pereiraafl/rodeiro/DIAGRAM.md

# Esquemático elétrico

### Diagrama do Arduino responsável por obter a temperatura

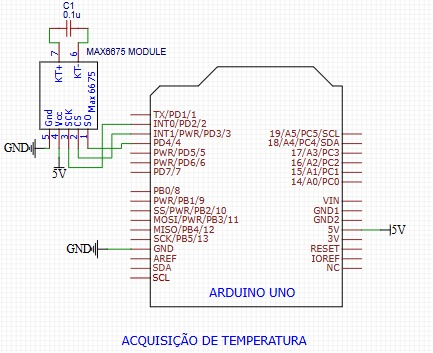
[picture p3: assets/arduino_temp.jpeg]
ArduinoTemp


### Diagrama do Arduino responsável pelo controle do inversor e da central hidráulica

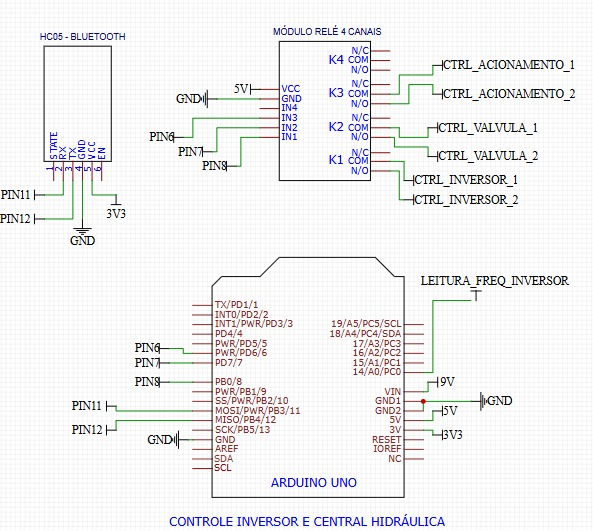
[picture p4: assets/arduino_control.jpeg]
ArduinoControl
