pereiraafl/rodeiro/(commit log)

2024-09-28 Update - Comments and timings
    - Added comments to the code
    - Reset the timings between braking proceedures
    - Commented the valve-closing section to allow the fluid to keep moving during acceleration
2024-10-09 Update: thermocouple and LCD
    > Added thermocouple readings and LCD prints to code
    > Added comments to describe the new parts of the code
2024-10-14 Add arduino nano code
2024-10-14 Update arduino uno code
2024-10-14 Add python script to interact with arduinos
2024-10-14 Remove rodeiro.ino since its code is now on arduino_uno.ino
2024-10-31 Add socket echo implementation
2024-10-31 Add on/off socket logic
2024-10-31 Add socket and test integration with on/off logic
2024-10-31 Add socket communication in python script
2024-11-09 Change style buttons
2024-11-09 Add button request
2024-11-18 Fix bug where socket was being sent only to the first user connected
2024-11-21 Add confirmation when turning off arduino
2024-11-21 Update latest version of arduino uno code
2024-12-18 Increase timer for fetching data to respect zrok's limit
2024-12-18 Add latest arduino_uno code
2024-12-18 Update latest arduino_nano code
2024-12-18 Change arduino uno so that it can turn off without breaking
2024-12-18 Change /arduino/off route and sockets to work with new breaking style
2024-12-18 Change socket and writing to arduino to work with new breaking style
2025-01-29 Add delete and download buttons on dropdown
2025-02-10 Add timeout to serial as a workaround for possible break bugs
    [main_backend.py]
2025-02-17 Change bluetooth and serial arduinos.
2025-02-17 Change bluetooth to serial on arduino nano code
2025-02-17 Change serial to bluetooth on Arduino Uno code
2025-02-17 Add timeout for serial and bluetooth. Fix bugs with exceptions
    [mudanca_bluetooths.py]
2025-02-19 Start docs for Case de Cima
2025-02-21 Add missing timeout when trying to reconnet on reconnect_arduino_nano_serial
    [mudanca_bluetooths.py]
2025-02-24 Update README.md with new arduino setup and rename firmware files
